glynch-NA/SAP-1-Breadboard/README.md

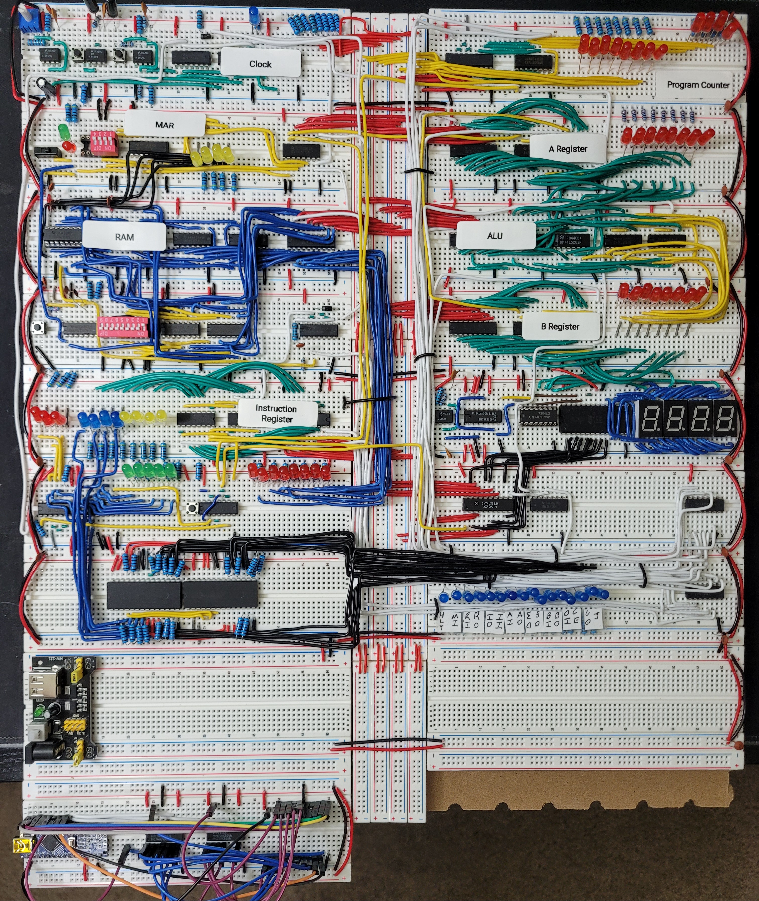
[picture p1: Images/Overview.jpg]
Project Screenshot


# SAP-1-Breadboard
Based on Ben Eater's video series on YouTube & the schematics available on his website https://eater.net/8bit, this 8-bit SAP (Simple As Possible) breadboard computer project is a colorful introduction to basic computer architecture. 

Built almost entirely using logic ICs, with some more complex components and additions, the 8-bit breadboard CPU demands a resilient mindset in order to complete. There are many setbacks and unexpected issues that arise from the physical implementation of a great number of individual components. These problems range from diagnosing faulty hardware to unpredictable behaviors of certain components due to the breadboard environment. Its a great project to test your problem solving capabilities and patience. 

My goal with this documentation is to share the insights I gained and where I found solutions to problems which were beyond my expertise. 

[Solutions to problems](https://github.com/glynch-NA/SAP-1-Breadboard/blob/main/problems.md#problems-encountered-and-fixed) 

[Arduino](https://github.com/glynch-NA/SAP-1-Breadboard/blob/main/Arduino/ArduinoControl.md#arduino-control-augmentation)

## Overview
The computer is able to be programmed manually through the MAR and RAM modules using dip switches, where binary instructions are input to locations within memory which the computer then advances through. The control logic of the computer uses two AT28C64B EEPROMs that are programmed using a homemade Arduino Nano EEPROM programmer. The EEPROMs translate the binary instruction that is stored in RAM to microcode that the control logic then runs through. 

### Modules
- **Clock** - Adjustable/manual timing control.
- **Memory Address Register** - Selects memory location from bus or manually.
- **Random Access Memory** - Program and data storage. Can be programmed manually.
- **Instruction Register** - Instruction storage. Data from bus to control logic and back out to bus. 
- **Control Logic** - Instruction interpretation and sequence counter. Displays what control bits are in use. 
- **Program counter** - Displays where in the program the computer is and what to execute next.
- **A Register** - Storage of an 8-bit value for ALU use or immediate access.
- **ALU** - Performs addition and subtraction operations using A and B registers.
- **B Register** - Stores an 8-bit value for use in the ALU.
- **Display** - Is able to output the value on the bus to 7-segment displays. 

## Control Lines
- **HLT** - Halt - Stops the system clock. 
- **MI** - MAR In - Accepts a 4-bit piece of data from the first four bits of the bus into the MAR.
- **RI** - RAM In - Stores the contents of the bus in memory.
- **RO** - RAM Out - Outputs the data in memory to the bus.
- **IO** - Instruction register Out - Outputs the contents of the first four bits of the instruction register to the bus.
- **II** - Instruction register In - Reads the contents of the bus into the instruction register.
- **AI** - A register In - Stores the contents of the bus into the A register.
- **AO** - A register Out - Outputs the contents of the A register to the bus.
- **EO** - Sum Out - Outputs the contents of the ALU to the bus.
- **SU** - Subtract - Enables the subtraction operation in the ALU.
- **BI** - B register In - Stores the contents of the bus into the B register.
- **BO** - B register Out - Outputs the contents of the B register to the bus.
- **OI** - Output In - Reads the contents of the bus into the output module and displays it.
- **CE** - Counter Enable - Enables the program counter.
- **CO** - Counter Out - Outputs the program counter contents to the bus.
- **J** - Jump - Jumps the program counter to the 4-bit value held on the bus. 

## Instructions
```
v : 4-bit value between 0000 and 1111.
Example: ADD 15 - Adds the contents of register A with the data stored in memory location 15 (1111) and stores the sum in register A.

0000 - NOP - No operation
0001 - LDA v - Loads Register A with data from memory location v
0010 - ADD v - Adds the contents of register A with the data stored in memory location v and stores the sum in register A.
0011 - SUB v - Subtracts the contents of memory location v from the value stored in the A register and stores the sum in register A.
0100 - STA v - Stores the contents of the A register into memory location v.
0101 - LDI v - Loads the value v into register A.
0110 - JMP v - Sets the program counter to value v.
.
.
.
1110 - OUT - Displays the contents of the A register in the display module.
1111 - HLT - Halts the system clock.
```

## Instruction Sequence
1. Fetches Instruction.
2. Instruction is read into control logic. 
3. Performs Instruction specific operations.
4. Advances to next instruction unless halted or jumped.

## Program Example - Fibonacci Sequence
Programming the computer requires enabling the manual memory address selection mode using a toggle switch and inputting desired values (instructions) into the memory. 

The following code takes the form: Assembly | Memory address | RAM contents

The RAM contents include the binary form of the assembly instruction where the first four bits (least significant, rightmost) are the values either for memory location, step to jump to, or what to load immediately into the A register. The last four bits (most significant, leftmost) are for the instruction as defined above in [Instructions](#instructions). 
```
Initial Programming required:
Memory Location | Value/RAM Contents
1110 | 0000 0000
1111 | 0000 0001

Program:
Assembly | Memory Location | RAM Contents
LDA 14 | 0000 | 0001 1110
OUT    | 0001 | 1110 0000
ADD 15 | 0010 | 0010 1111
OUT    | 0011 | 1110 0000
STA 15 | 0100 | 0100 1111
LDA 14 | 0101 | 0001 1110
ADD 15 | 0110 | 0010 1111
OUT    | 0111 | 1110 0000
STA 14 | 1000 | 0100 1110
LDA 14 | 1001 | 0001 1110
ADD 15 | 1010 | 0010 1111
OUT    | 1011 | 1110 0000
JMP 4  | 1100 | 0110 0100
```
