glynch-NA/SAP-1-Breadboard/Images/Clock_MAR_RAM.jpg

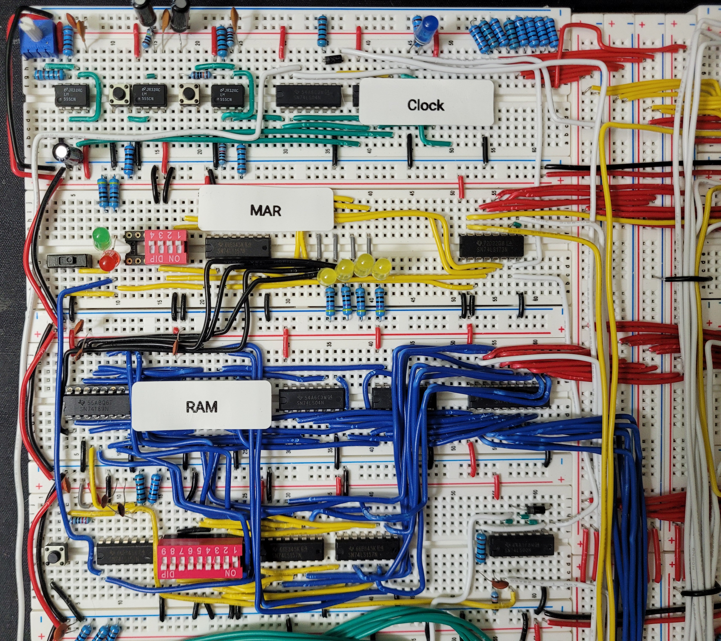
Images/Clock_MAR_RAM.jpg
