glynch-NA/SAP-1-Breadboard/Images/DisplayModule_ControlLines.jpg

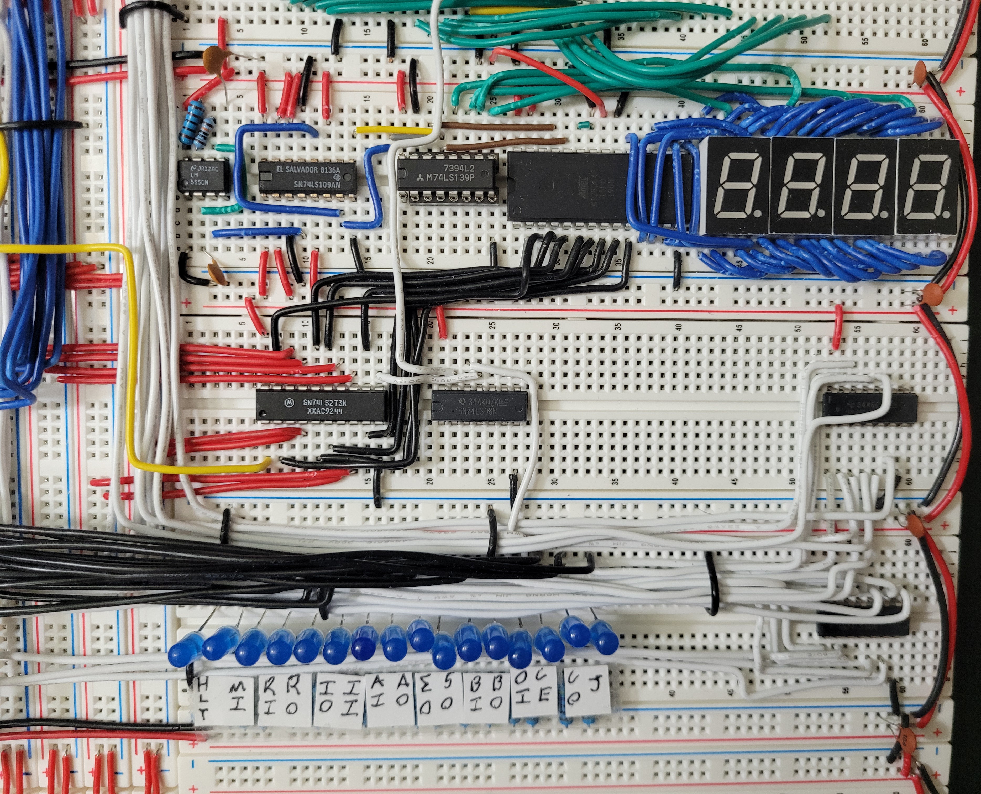
Images/DisplayModule_ControlLines.jpg
