glynch-NA/SAP-1-Breadboard/Images/Power_EEPROMProgrammer.jpg

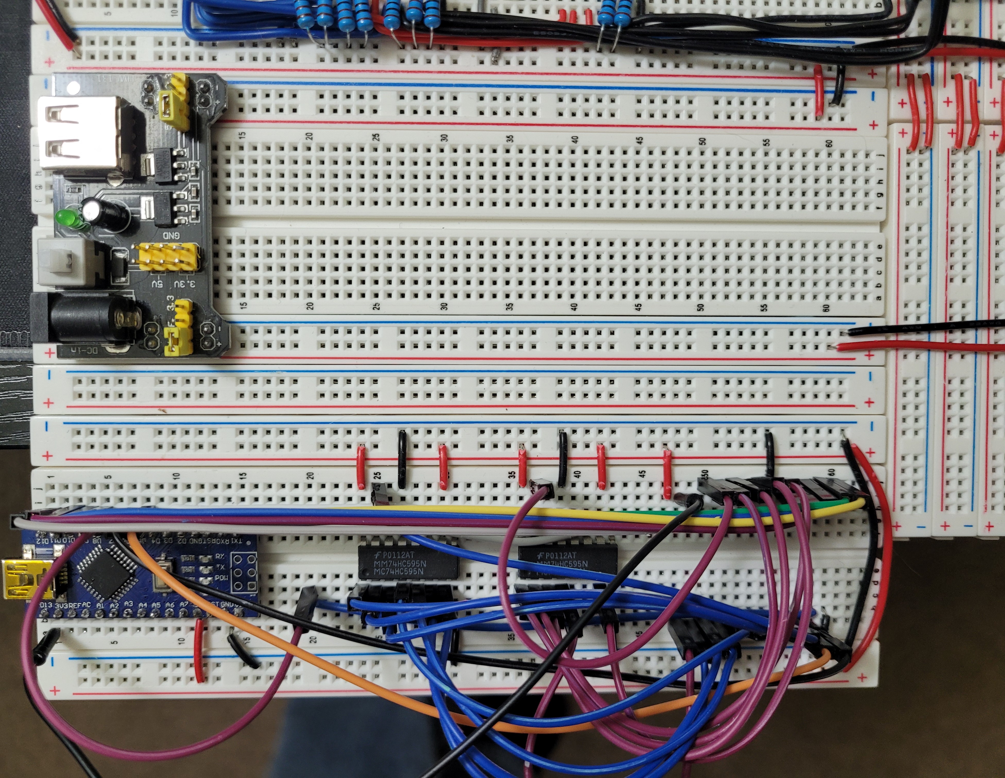
Images/Power_EEPROMProgrammer.jpg
