glynch-NA/SAP-1-Breadboard/Images/ProgramCounter_Registers_ALU.jpg

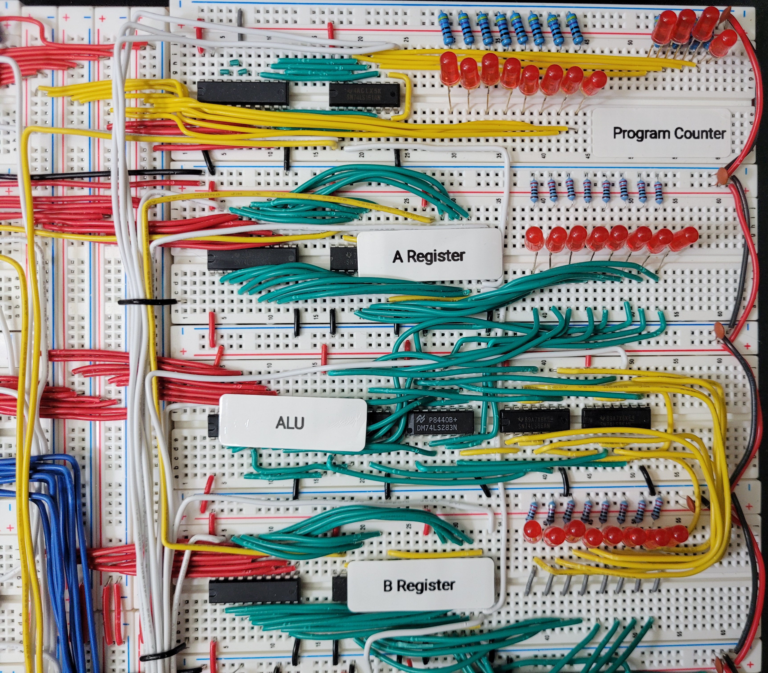
Images/ProgramCounter_Registers_ALU.jpg
