glynch-NA/SAP-1-Breadboard/Images/InstructionReg_ControlLogic.jpg

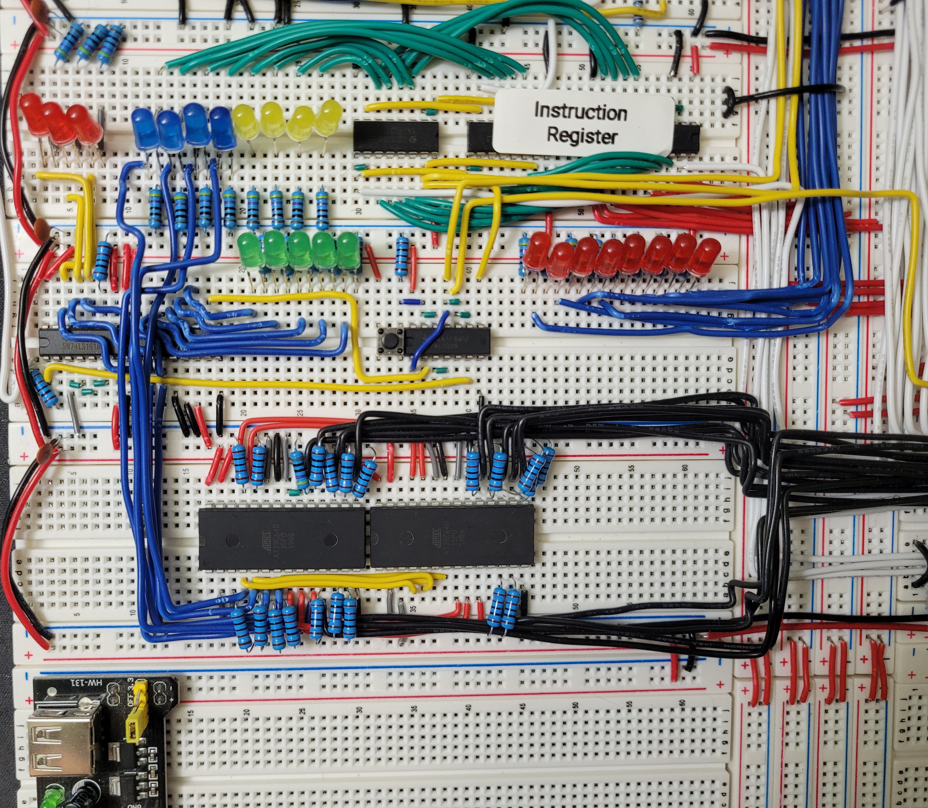
Images/InstructionReg_ControlLogic.jpg
