glynch-NA/SAP-1-Breadboard/problems.md

# Problems Encountered and Fixed
Many of the issues I came across have already been addressed on the Ben Eater Reddit troubleshooting page where in depth explanations about most issues can be found. The link to that page is https://www.reddit.com/r/beneater/wiki/troubleshooting/ . Not all issues that I encountered are listed here, many were simple wiring mistakes. Always triple check your connections! 

* Inconsistent behavior from the memory modules
  - After noticing that the operation of the RAM/MAR modules depended on whether the breadboards were perfectly level or not I inspected each component on the boards. What I found was that the pins on the     74LS189s were too short to properly fit into the sockets of the breadboard. The solution was to use dip risers for both of these chips to secure a good connection.
* Fragile power supply
  - The power supply needs to be connected to a breadboard that is directly attached to the computer itself. Running wires across an open gap between the power supply and the computer lead to too many accidental resets.
* Memory corruption
  - When switching between PROG/RUN mode using the toggle switch, the contents of the RAM would be erased. A detailed explanation is offered here https://github.com/blurpy/8-bit-computer/blob/master/issues.md#ram-mode-switch-changes-memory-content and here https://www.reddit.com/r/beneater/wiki/troubleshooting/. To sum it up, there is a brief moment when the write enable (WE) to the 74ls189s goes low when the switch is toggled, leading to the RAM to store whatever is on its inputs at that moment. The fix is to add a .1uF (or .01uF if .1uF doesnt work) capacitor over the write enable line of the RAM chip to vcc. What worked for me was two 22pF ceramic capacitors in parallel across the write enable line to vcc.
* Program counter double counting
  - The program counter was counting on both the rising and falling edge of the clock signal. A solution is found here https://www.reddit.com/r/beneater/comments/j9yrqr/program_counter_counting_on_both_rising_and/ and here https://www.reddit.com/r/beneater/comments/curlvs/comment/eykh64s/?utm_source=share&utm_medium=web2x&context=3. The RAM edge detector was interfering with the system clock pulse due to the setup of the capacitor on the edge detector. The solution is to double invert the edge detector to isolate its signal using the unused NAND gates on the 74ls00n.
* Clock registers multiple pulses when switching modes
  - When toggling between step and auto, the clock module was sending multiple signals through the system. I found a solution here https://www.reddit.com/r/beneater/comments/eai6ke/issue_with_clock_kit_and_possible_solution_with/ . A unique solution to the issue where they change the form of toggling between clock modes to a push button. After implementing this I had no further issues.
* Random display module output
  - When there are no modules outputting to the bus there are random numbers on the 7-segment displays. I believe this is due to the 74ls273 not registering that there are no values on the bus. I've tried using multiple different pull down resistors for the bus but that doesn't seem to change anything. The fix for this is to just ignore it as when you program the computer there will not be a time when that you are displaying directly from the bus. It will always be from the A register which will not have floating values.
* EEPROM not programming
  - The EEPROMs have the capability to lock their contents using SDP (Software Data Protection). Two EEPROMs came with SDP disabled, one did not. To turn off SDP a certain sequence of bytes must be issued to the chip. The code for how to do so can be found here https://github.com/TomNisbet/TommyPROM/blob/master/unlock-ben-eater-hardware/unlock-ben-eater-hardware.ino
* Instruction step counter skipping
  - While running through a simple program that uses the STA instruction, the computer was not executing the second step of the instruction to load the contents of the bus into the instruction register. The control lines/leds indicated that the control word was correct but when stepping through the instruction, the control logic would skip ahead two steps.
  - After quite some time I was able to figure out that EEPROMs needed a slight delay in receiving the inverted clock signal in order to give them time to swap the data pins from their previous output to a new one without leaving floating data values when the address changes.
  - This seemed to fix it sometimes. Another add on was to place a diode as well as a pulldown resistor to the HLT control line before the 74ls04 so that no signals flow backwards when the clock pulses.
 
# General Fixes
* You can find many general solutions on the troubleshooting page such as adding pull up/down resistors to most input lines on each chip and resistors in series with all LEDs. There are a few other things I would recommend though.
  - Buy 24 gauge wire or thinly insulated 22 gauge wire. The 22 gauge wire I purchased was far too thick to bend properly so I ended up with some sections of wire looking like a snake.
  - If you can afford it certainly buy an oscilloscope and a high quality DVM. Having reliable tools such as these make troubleshooting a breeze.
  - Get yourself a piece of wood or pegboard to put the computer on when it nears completion. Moving the computer when all that's holding it together are some wires between boards begs for tragedy.
