glynch-NA/SAP-1-Breadboard/(commit log)

2026-09-18 Create ArduinoControl
2026-09-18 Update and rename ArduinoControlLines.md to ArduinoControl.md
2026-09-18 Add Arduino control code for serial input handling
2026-09-18 Change command from 'SO' to 'EO' and update pin logic
2026-09-18 Update README with additional resource links
    Added links to solutions and Arduino control documentation.
